H-Elden/Triangular-Magnetic-Crane/SYSTEM/usart/uart2.c

#include "misc.h"
#include "stm32f10x.h"
#include "stm32f10x_gpio.h"
#include "stm32f10x_rcc.h"
#include "stm32f10x_usart.h"
#include "wit_c_sdk.h"
#include <stdio.h>

void Usart2Init(unsigned int uiBaud)        // USART2(串口2)初始化配置
{
    GPIO_InitTypeDef  GPIO_InitStructure;         // GPIO命名
    USART_InitTypeDef USART_InitStructure;        // USART命名
    NVIC_InitTypeDef  NVIC_InitStructure;         // 中断NVIC命名

    RCC_APB2PeriphClockCmd(RCC_APB2Periph_GPIOA, ENABLE);         // 时钟配置GPIOA
    RCC_APB1PeriphClockCmd(RCC_APB1Periph_USART2, ENABLE);        // 时钟配置USART2

    // 485 control pin
    GPIO_InitStructure.GPIO_Pin   = GPIO_Pin_1;        // GPIO配置配置pin1
    GPIO_InitStructure.GPIO_Mode  = GPIO_Mode_Out_PP;
    GPIO_InitStructure.GPIO_Speed = GPIO_Speed_50MHz;
    GPIO_Init(GPIOA, &GPIO_InitStructure);
    GPIO_SetBits(GPIOA, GPIO_Pin_1);

    GPIO_InitStructure.GPIO_Pin   = GPIO_Pin_2;
    GPIO_InitStructure.GPIO_Mode  = GPIO_Mode_AF_PP;
    GPIO_InitStructure.GPIO_Speed = GPIO_Speed_50MHz;
    GPIO_Init(GPIOA, &GPIO_InitStructure);

    GPIO_InitStructure.GPIO_Pin  = GPIO_Pin_3;
    GPIO_InitStructure.GPIO_Mode = GPIO_Mode_IN_FLOATING;
    GPIO_Init(GPIOA, &GPIO_InitStructure);

    USART_InitStructure.USART_BaudRate            = uiBaud;        // USART配置
    USART_InitStructure.USART_WordLength          = USART_WordLength_8b;
    USART_InitStructure.USART_StopBits            = USART_StopBits_1;
    USART_InitStructure.USART_Parity              = USART_Parity_No;
    USART_InitStructure.USART_HardwareFlowControl = USART_HardwareFlowControl_None;
    USART_InitStructure.USART_Mode                = USART_Mode_Rx | USART_Mode_Tx;
    USART_Init(USART2, &USART_InitStructure);
    USART_ITConfig(USART2, USART_IT_RXNE, ENABLE);

    USART_Cmd(USART2, ENABLE);
    NVIC_InitStructure.NVIC_IRQChannel                   = USART2_IRQn;        // 中断配置USART2
    NVIC_InitStructure.NVIC_IRQChannelPreemptionPriority = 0;
    NVIC_InitStructure.NVIC_IRQChannelSubPriority        = 2;
    NVIC_InitStructure.NVIC_IRQChannelCmd                = ENABLE;
    NVIC_Init(&NVIC_InitStructure);
}
void USART2_IRQHandler(void) {
    unsigned char ucTemp;
    if (USART_GetITStatus(USART2, USART_IT_RXNE) != RESET)        // 判断是否有数据接收
    {
        ucTemp = USART_ReceiveData(USART2);                    // 接收数据并赋值
        WitSerialDataIn(ucTemp);                               // 接收到的数据传入WitSerialDataIn函数中
        USART_ClearITPendingBit(USART2, USART_IT_RXNE);        // 把接收到的数据清零
    }
}
void Uart2Send(unsigned char *p_data, unsigned int uiSize)        // 串口2数据发送
{
    unsigned int i;
    for (i = 0; i < uiSize; i++) {
        while (USART_GetFlagStatus(USART2, USART_FLAG_TXE) == RESET);        // 判断数据发送是否完成
        USART_SendData(USART2, *p_data++);                                   // 串口2数据发送
    }
    while (USART_GetFlagStatus(USART2, USART_FLAG_TC) == RESET);
}
