H-Elden/Triangular-Magnetic-Crane/HARDWARE/wit_c_sdk.h

#ifndef __WIT_C_SDK_H
#define __WIT_C_SDK_H

#ifdef __cplusplus
extern "C" {
#endif

#include <stdint.h>
#include <stdio.h>
#include <string.h>
#include "REG.h"


#define WIT_HAL_OK      (0)     /**< There is no error */
#define WIT_HAL_BUSY    (-1)    /**< Busy */
#define WIT_HAL_TIMEOUT (-2)    /**< Timed out */
#define WIT_HAL_ERROR   (-3)    /**< A generic error happens */
#define WIT_HAL_NOMEM   (-4)    /**< No memory */
#define WIT_HAL_EMPTY   (-5)    /**< The resource is empty */
#define WIT_HAL_INVAL   (-6)    /**< Invalid argument */

#define WIT_DATA_BUFF_SIZE  256

#define WIT_PROTOCOL_NORMAL 0
#define WIT_PROTOCOL_MODBUS 1
#define WIT_PROTOCOL_CAN    2
#define WIT_PROTOCOL_I2C    3


/* serial function */
typedef void (*SerialWrite)(uint8_t *p_ucData, uint32_t uiLen);
int32_t WitSerialWriteRegister(SerialWrite write_func);
void WitSerialDataIn(uint8_t ucData);

/* Delayms function */
typedef void (*DelaymsCb)(uint16_t ucMs);
int32_t WitDelayMsRegister(DelaymsCb delayms_func);

typedef void (*RegUpdateCb)(uint32_t uiReg, uint32_t uiRegNum);
int32_t WitRegisterCallBack(RegUpdateCb update_func);
int32_t WitWriteReg(uint32_t uiReg, uint16_t usData);
int32_t WitReadReg(uint32_t uiReg, uint32_t uiReadNum);
int32_t WitInit(uint32_t uiProtocol, uint8_t ucAddr);

int32_t WitSetUartBaud(int32_t uiBaudIndex);
int32_t WitSetOutputRate(int32_t uiRate);


char CheckRange(short sTemp,short sMin,short sMax);

extern int16_t sReg[REGSIZE];

#ifdef __cplusplus
}
#endif

#endif /* __WIT_C_SDK_H */
