H-Elden/Triangular-Magnetic-Crane/(commit log)

2024-07-17 保存程最早的代码
2024-07-17 程7.17-23.38
2024-07-20 程7.19.已经整合了新步进；完善了整体逻辑；加入了步进上电检测。暂时注释掉了步进3
2024-07-20 程7.20
2024-07-21 加入正确的场地点位图。重构了程的代码
2024-07-21 修改了switch中忘记break的错误。新增了步进速度和加速度的宏定义
2024-07-22 修改了一些错误
2024-07-22 加入了使用计时判断步进的策略
2024-07-22 7.22修改，速度1500
2024-07-23 概率性卡机问题
2024-07-23 程修改行进，测试速度1500，7.23-16.57
2024-07-23 解决了way0且中间砝码在F的情况
2024-07-24 修改了优先级。直线加速。
2024-07-25 7.25上午，测试2000速度不成功，会急停
2024-07-25 程7.25-14.22行进
2024-07-26 修改了D点停车后加速的问题
2024-07-27 步进速度400，加速度240
2024-07-28 1.行进速度1600，步进速度分开，垂直速度400，加速度240；水平速度400，加速度230。2.加入带负载上升的计时。3.高罩子，在HI线放置后少上升5度。4.防止F到D和C到D撞倒木桩，多延时了500ms
2024-07-28 赛场测试1
2024-07-29 1.D点延时；2.删去了一些延时
2024-07-30 赛场测试2
2024-08-11 修改了一些延时，重新测量了步进时间，重写了步进测时间的函数
2024-08-12 速度提到2500，增加延时防止撞倒高木桩。增加高木桩提前减速距离的计算。
2024-08-13 改了新逻辑。修改了C2和Z0高度。修改了H到D的减速度
2024-08-13 将步进精度由0.3度又改回3.0度
2024-08-13 步进不动
2024-08-14 注释掉了没用的陀螺仪代码
2024-08-14 删去了没用的代码
2024-08-14 1.加速度1200，减速度800；2.第一次停减速度1400；3.行进PID由50改为100；4.行进在H处减速改思路
2024-08-15 删去了防止撞倒矮木桩的100ms延时
2024-08-15 修改了陀螺仪回传速率为10Hz，试图解决冲出的问题
2024-08-19 1.加上消磁电路和代码；2.C2高度设置为950，减少了30
2024-08-20 消磁延时由20ms改为5ms
2024-08-20 1.修改轮径为真实半径；2.去掉了H木桩停车的+5修正
2024-08-21 C2由950改到970
2024-08-21 1.Turn函数100改到50；2.100Hz改到50Hz；3.主函数I木桩的补偿5去掉
2024-08-21 增加消磁代码
2024-08-21 1.删掉最后的抓手收回；2.后面停车向前补偿5mm
2024-08-22 轮径改回32.3和32.15
2024-08-22 1.轮径改回真实值；2.计步数采用平均值；3.删去后面补偿的5mm；4.水平步进角度调整为真实值
2024-08-22 删去左右轮径，统一为同一个
2024-08-22 1.C2由970降到960；2.消磁由5ms加到10ms；3.后面木桩向前补偿2.5cm
2024-08-25 后面木桩再向前木桩5mm
2024-08-26 加入详细的readme
2024-08-27 1.修改了.vscode/c_cpp_properties.json配置文件的include并跟踪；2.修改了.gitignore文件。
2024-08-27 修改了Keil里的include设置,删去了文件夹README
2024-08-27 修改了缩进，使用vscode的自动格式化
2024-08-27 改进缩进
2025-05-02 修正：修改README.md
2026-07-15 更新文档
